R2DeezNuts/EggBot-Sumo-Battlebot-/README.md

# Proxecto Battlebot · Equipo Eggbots

Este repositorio reúne o deseño, o software e a documentación do noso BattleBot. A [web de Eggbots](https://battlebots.robotica.gal/Eggbots/) recolle a documentación completa do proxecto.

## Equipo
O equipo está formado por:
- **Enrique Comesaña Figueroa**: Coordinador e responsable do deseño de hardware e da construción.
- **Juan José Prado Neira**: Responsable do deseño e da implementación do software.
- **Marcos Fernández González**: Responsable da web e da documentación.
- **Javier Rego Bargos**: Responsable do deseño mecánico e electrónico.

## Estrutura do repositorio

O repositorio organízase en:
- ***README.md***: Este ficheiro.
- ***web***: Código fonte da web do proxecto.
- ***electronica***: Deseño dos circuítos de control e das placas.
- ***mecanica***: Deseño da estrutura do robot e planos de fabricación.
- ***software***: Software do robot.
- ***.gitlab-ci.yml***: Proceso de publicación da web.

## Compoñentes

Consulta a [lista de compoñentes](https://docs.google.com/spreadsheets/d/1ZMKZPNqryC1lRq46kaxvph4U0cHYfyVd0BvwiHCcG7o/edit?usp=sharing) para ver o material empregado.
