R2DeezNuts/EggBot-Sumo-Battlebot-/web/costes.md

---
layout: page
title: Costes a materiais
---

| Compoñente | Cantidade | Prezo aprox. (EUR) | Comentarios | Enlace de compra |
|---|---|---|---|---|
| **Motor Mabuchi RZ‑735VA‑9517 con cables cortos**| 2 | 17,395 |Motor, peso 290g | [Aliexprees](https://es.aliexpress.com/item/1005008892261311.html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) |
| **Sensor reflectancia QRE1113 sin cables** | 4 | 1,0225 | peso 0,5g | [Aliexprees](https://es.aliexpress.com/item/1005006863973407.html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) |
| **Sensor infrarrojo distancia con cables** | 1 | 5,34 | peso 17g | [Aliexprees](https://es.aliexpress.com/item/1005006989122809.html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) |
| **Sensores GP2Y0A21YK0F con cables** | 2 | 3,845 | Peso 12g | [Aliexpress](https://es.aliexpress.com/item/1005003745155535.html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) |
| **Tornillos varios ** | 1 | 1 | peso 40g |  |
| **Bateria 4s 850mAh 150C** | 1 | 0 | Peso 100g | |
| **Terminal** | 4 | 0,02 | peso 1 g | |
| **Chasis ABS completo** | 1 |0 | peso 350g | |
| **Cuña frontal 1 acero mm** | 1 | 0 | 35g | |
| **Eje 200x5 al 6061 hueco 5x3** | 3 | 0 | peso 3g,5g | |
| **Eje 72x5 al 6061 macizos** | 2 | 0 | peso 3g,9g | |
| **Llanta 35 mm × 22 mm ancho** | 2 | 0 | peso 16g | |
| **PCB** | 1 | 8,86 | peso 18g | |
| **220 uF 16v electrolitico** | 1 | 0,6 | peso 1g | |
| **0,1 uF ceramico** | 7 | 1,50 | peso 01g | |
| **1000uF 25v electrolitico** | 1 | 0,04 | Peso 3g  | |
| **Interruptor** | 1 | 0,2 | Peso 3g | |
| **Silicona ruedas** | 2 | 12,45 | Peso 23g | |
| **Placa módulo 12V–48V 100A sin cables** | 1 | 43,02 | Peso 90g | [Aliexprees](https://es.aliexpress.com/item/32728776675.html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) |
| **Convertidor DC‑DC 3A 5V BEC con cables** | 1 | 2,98 | Peso 6g |[Aliexprees](https://es.aliexpress.com/item/32905033708.html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) |
| **XT30 M-F + 14awg** | 3 | 0 | Peso 6g  | |

| **Fusible 80A**                            | 1        | 2,5              | Peso 8g  |                                                                                                                                 |

| **Cables varios**                            | 1        | 0              | Peso 6g  |                                                                                                                                 |

| **ESP32-WROOM-32U**                            | 1        | 0              | Peso 9g  |                                                                                                                                 |

**Total aproximado (sen incluír o custo da man de obra):** 151 EUR (depende de calidade e lugar de compra)

### Notas:
- Os prezos son estimativos, poden variar segundo país e fornecedor.
- O chasis impreso en 3D pode substituírse por acrílicom, madeira ou aluminio.
- Esta lista cobre **hardware**, o software é libre.
