R2DeezNuts/EggBot-Sumo-Battlebot-/software/README.md

# Deseño software do robot
Nesta carpeta incluense implementación do software e información de instalación no robot.

A carpeta ten a seguinte estructura:
- ...
- ...
