R2DeezNuts/EggBot-Sumo-Battlebot-/web/fotos.md

---
layout: page
title: Fotos e vídeos
---

<div class="gallery">
  <div class="photo">
    Foto 1
    <p>O logo do equipo, que na portada ás veces se fai de rogar.</p>
  </div>
  <div class="photo">
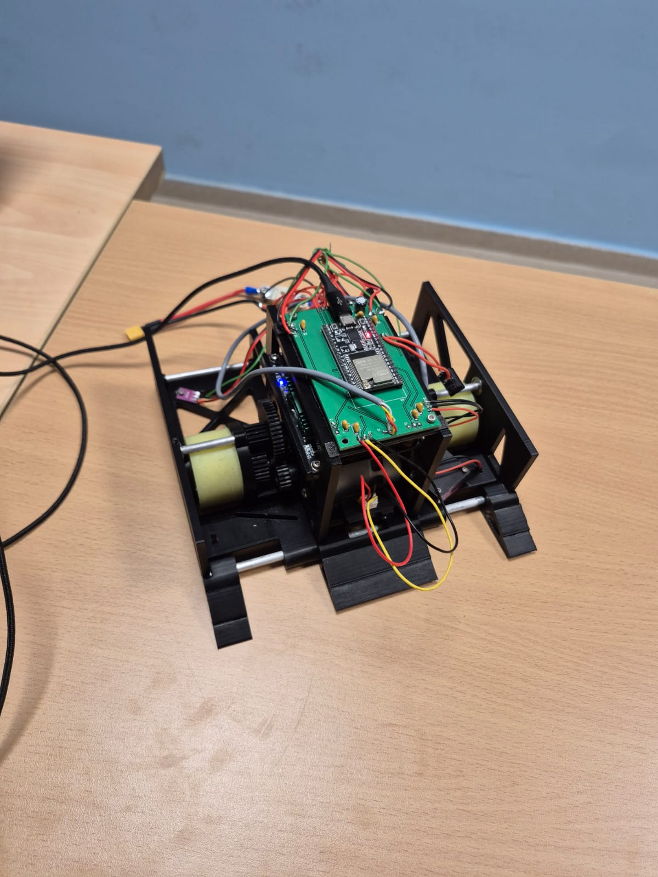
[picture p1: web/assets/fotos/battlebot.jpg]
Foto 2
    
    <p>Montaxe da placa controladora con ESP32.</p>
  </div>
  <div class="photo">
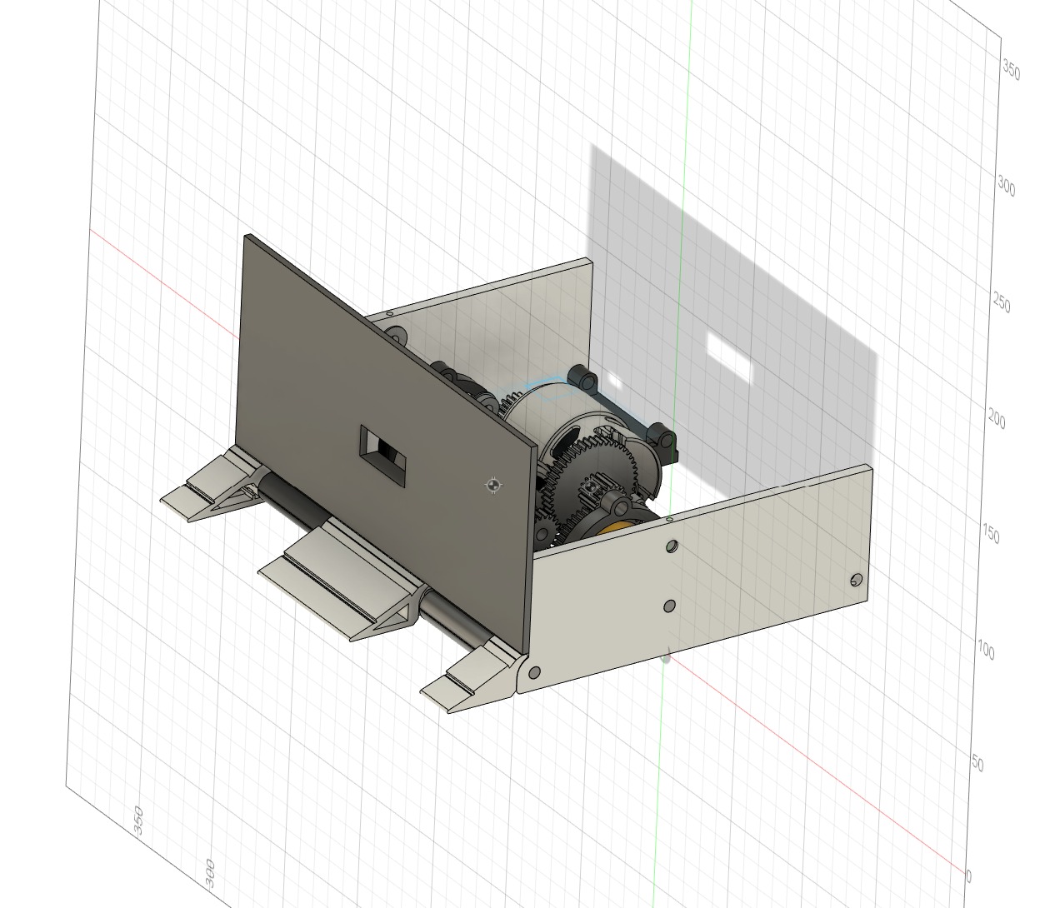
[picture p2: web/assets/fotos/battlebot_3D.jpg]
Foto 3
    
    <p>Un dos primeiros prototipos do chasis, impreso en 3D.</p>
  </div>
</div>

<style>
.gallery {
  display: flex;
  flex-wrap: wrap;
  gap: 20px;
  justify-content: center;
}
.photo {
  flex: 1 1 200px;
  text-align: center;
}
.photo img {
  max-width: 100%;
  border-radius: 8px;
  box-shadow: 0 2px 6px rgba(0,0,0,0.3);
}
.photo p {
  margin-top: 0.5em;
  font-size: 0.9em;
}
</style>
