R2DeezNuts/EggBot-Sumo-Battlebot-/web/index.md

---
layout: page
title: Inicio
---

# Benvido á web do equipo Eggbots

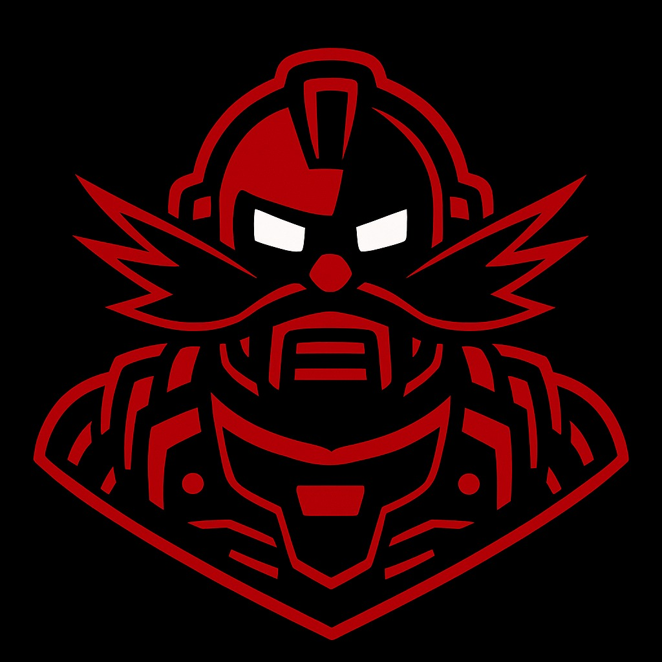
[picture p3: web/assets/img/Eggbots.png]
Logo Equipo Modelo


Somos estudantes do grao de Robótica da USC e estamos a construír un robot de combate pensado para moverse rápido e empuxar forte. O obxectivo é sinxelo: sacar o rival do cadrilátero antes de que nos saque a nós.

# O noso equipo

Aquí estamos as persoas que levamos o proxecto adiante:

<div class="team">
  <div class="member">
    <h2>Javier Rego Bargos</h2>
    <h3><strong>Rol: </strong>Programador</h3>
    <p>Encárgome do código que fai que o robot responda na area de combate. Moito dese código acaba sendo probar, medir e volver probar.</p>
  </div>

  <hr>

  <div class="member">
    <h2>Juan José Prado Neira</h2>
    <h3><strong>Rol: </strong>Líder do equipo, deseñador 3D e electrónico</h3>
    <p>Deseño o robot en 3D e a placa electrónica. Tamén coordino o equipo para que as pezas, o software e as probas vaian na mesma dirección.</p>
  </div>

  <hr>

  <div class="member">
    <h2>David Díaz González</h2>
    <h3><strong>Rol: </strong>Web e deseño mecánico</h3>
    <p>Actualizo a web e poño nela as especificacións do proxecto. No deseño mecánico, encárgome de que o robot cumpra as condicións da USC e aguante cando chega o momento de competir.</p>
  </div>
</div>

<style>
.logo_equipo {
    max-height: 300px;
}
.team {
  justify-content: space-around;
  gap: 20px;
  margin-top: 2rem;
}
</style>
