R2DeezNuts/EggBot-Sumo-Battlebot-/mecanica/Fusion/20251214_204636.jpg

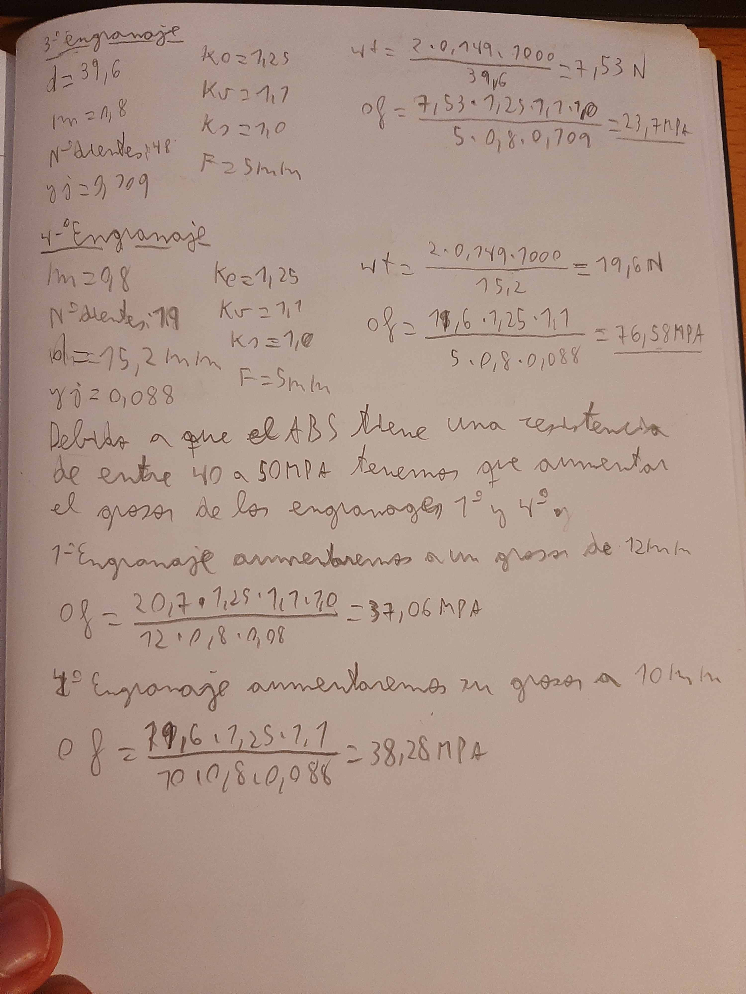
mecanica/Fusion/20251214_204636.jpg
