R2DeezNuts/EggBot-Sumo-Battlebot-/web/assets/fotos/63kehim7mik71.webp

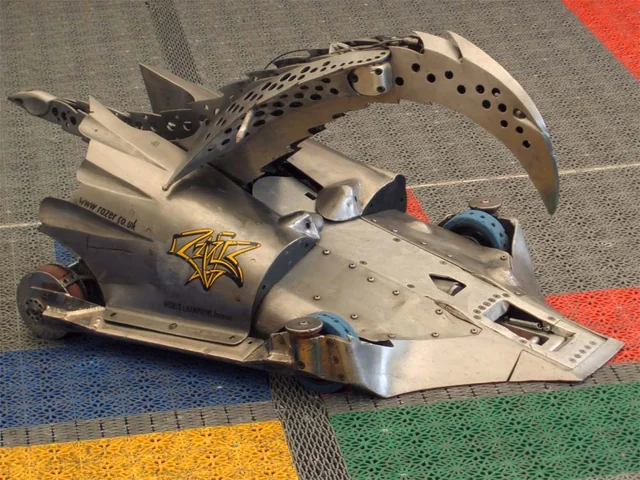
web/assets/fotos/63kehim7mik71.webp
