R2DeezNuts/EggBot-Sumo-Battlebot-/web/assets/fotos/FTAFVW1HI3TXU4G.jpg

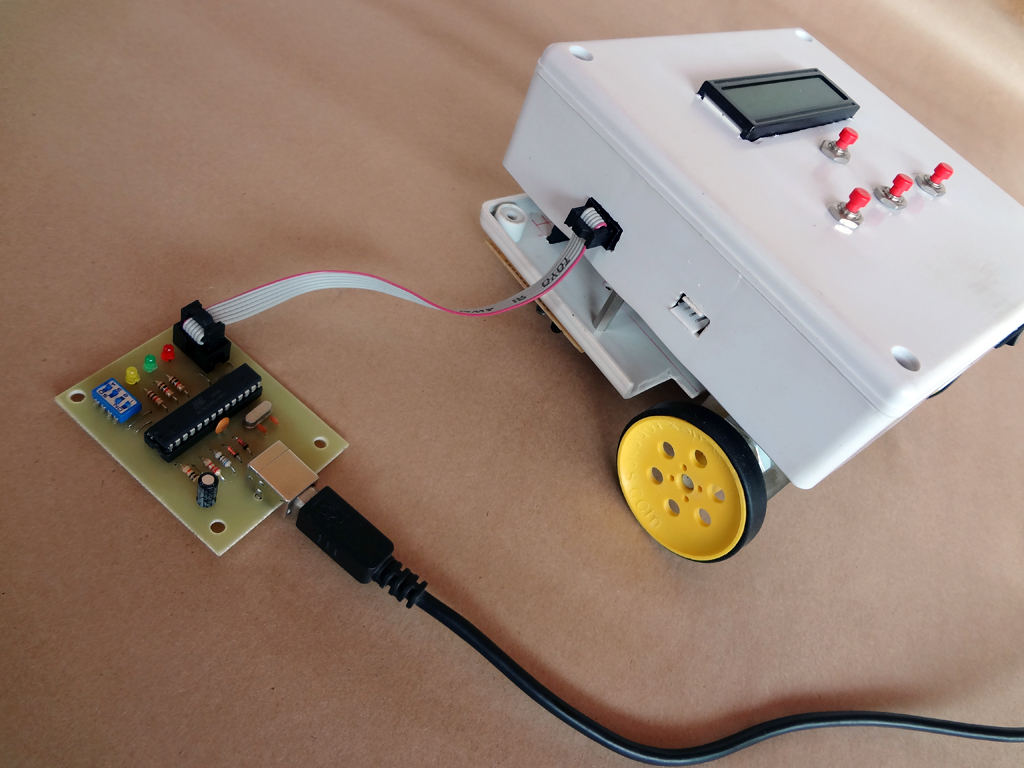
web/assets/fotos/FTAFVW1HI3TXU4G.jpg
