R2DeezNuts/EggBot-Sumo-Battlebot-/web/assets/img/foto_daniel.jpeg

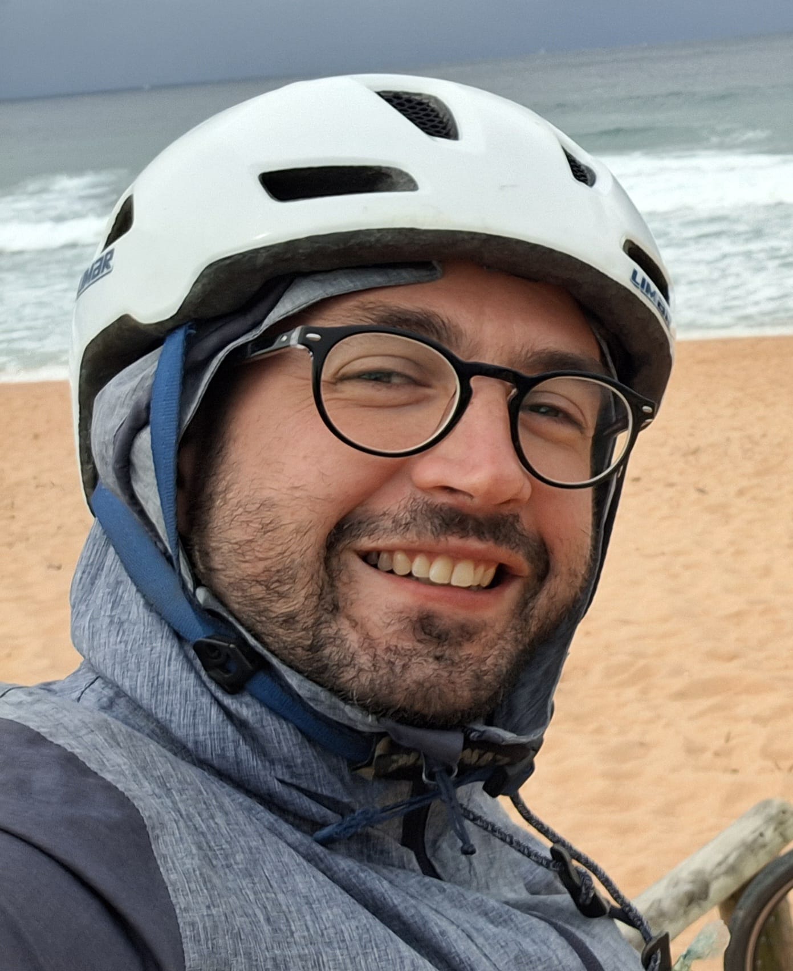
web/assets/img/foto_daniel.jpeg
