R2DeezNuts/EggBot-Sumo-Battlebot-/web/assets/img/foto_enrique.jpeg

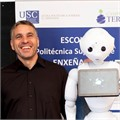
web/assets/img/foto_enrique.jpeg
