R2DeezNuts/EggBot-Sumo-Battlebot-/web/assets/img/foto_marcos.jpeg

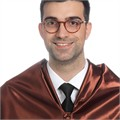
web/assets/img/foto_marcos.jpeg
