R2DeezNuts/EggBot-Sumo-Battlebot-/WhatsApp Image 2026-09-12 at 15.47.21.jpeg

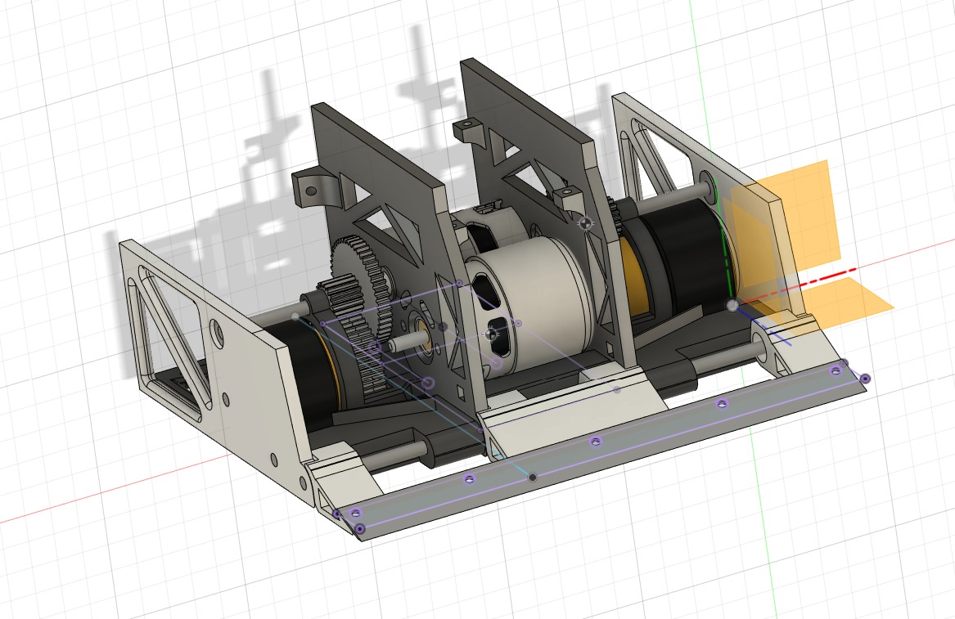
WhatsApp Image 2026-09-12 at 15.47.21.jpeg
