R2DeezNuts/EggBot-Sumo-Battlebot-/(list of files, cad)

Other CAD files:
mecanica/Fusion/battlebot_V2.f3d
