R2DeezNuts/EggBot-Sumo-Battlebot-/electronica/eggbot/eggbot.kicad_pcb

## KiCad design electronica/eggbot/eggbot.kicad_pcb (2026-09-12)

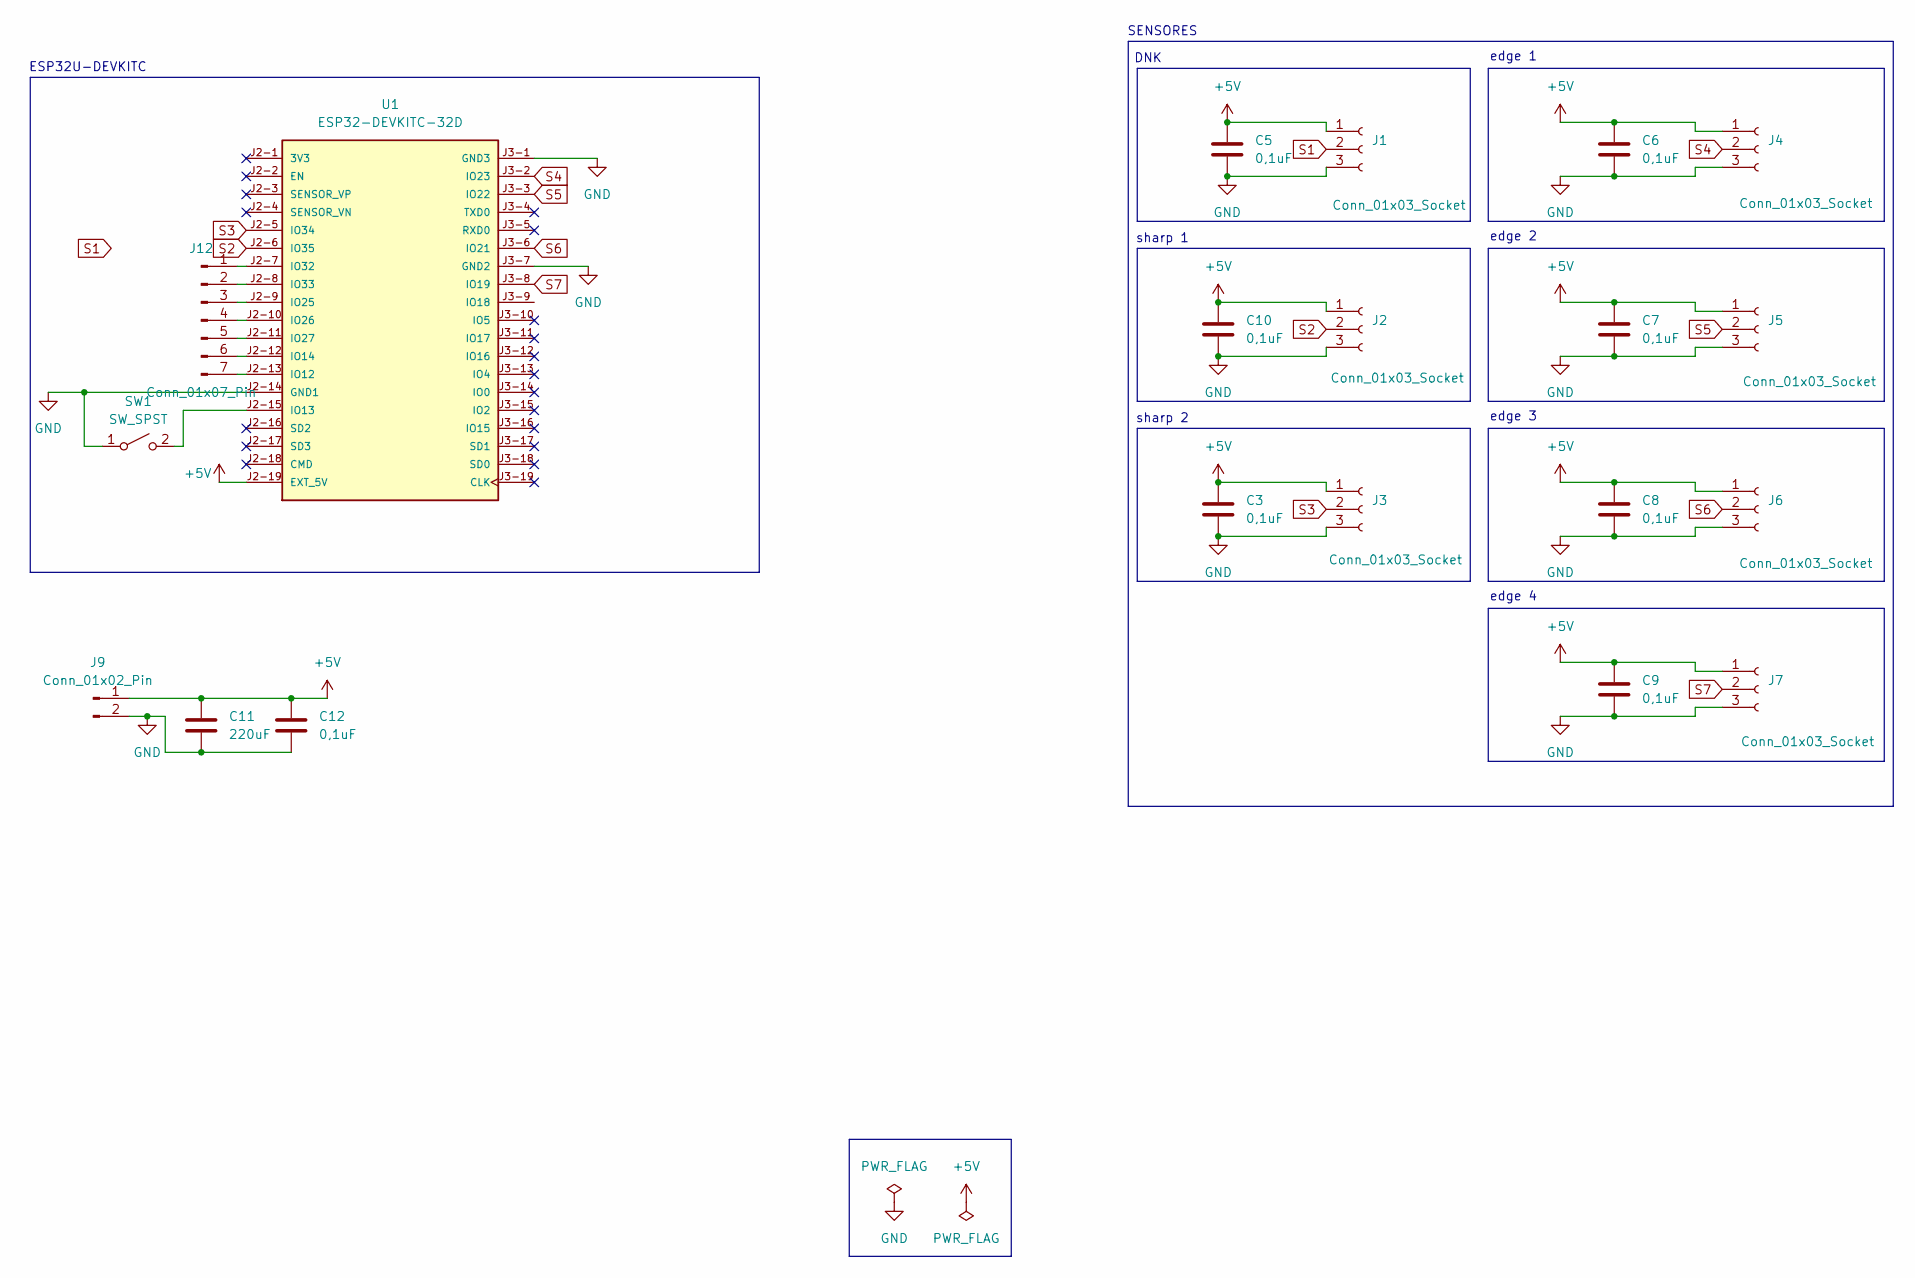
[picture p12: schematic eggbot.kicad_sch, battle_eggbot]

Parts:
C3, C5, C6, C7, C8, C9, C10, C12: 0,1uF; C_Disc_D4.3mm_W1.9mm_P5.00mm
C11: 220uF; CP_Radial_D4.0mm_P2.00mm
J1, J2, J3, J4, J5, J6, J7: Conn_01x03_Socket; pad_sensores_v2
J9: Conn_01x02_Pin; pad_salida_UBEC
J12: Conn_01x07_Pin; pad_7
SW1: SW_SPST; pad_2_èq
U1: ESP32-DEVKITC-32D; MODULE_ESP32-DEVKITC-32D; PARTREV V4

Connections:
+5V: C3.2, C5.2, C6.2, C7.2, C8.2, C9.2, C10.2, C11.2, C12.2, J1.1, J2.1, J3.1, J4.1, J5.1, J6.1, J7.1, J9.1, U1.J2-19 (EXT_5V)
GND: C3.1, C5.1, C6.1, C7.1, C8.1, C9.1, C10.1, C11.1, C12.1, J1.3, J2.3, J3.3, J4.3, J5.3, J6.3, J7.3, J9.2, SW1.1 (A), U1.J2-14 (GND1), U1.J3-1 (GND3), U1.J3-7 (GND2)
unnamed: J12.1, U1.J2-7 (IO32)
unnamed: J12.2, U1.J2-8 (IO33)
unnamed: J12.3, U1.J2-9 (IO25)
unnamed: J12.4, U1.J2-10 (IO26)
unnamed: J12.5, U1.J2-11 (IO27)
unnamed: J12.6, U1.J2-12 (IO14)
unnamed: J12.7, U1.J2-13 (IO12)
unnamed: SW1.2 (B), U1.J2-15 (IO13)
S1: J1.2, U1.J3-9 (IO18)
S2: J2.2, U1.J2-6 (IO35)
S3: J3.2, U1.J2-5 (IO34)
S4: J4.2, U1.J3-2 (IO23)
S5: J5.2, U1.J3-3 (IO22)
S6: J6.2, U1.J3-6 (IO21)
S7: J7.2, U1.J3-8 (IO19)

Notes on the sheet:
sharp 1
edge 3
DNK
ESP32U-DEVKITC
SENSORES
edge 4
edge 1
sharp 2
edge 2

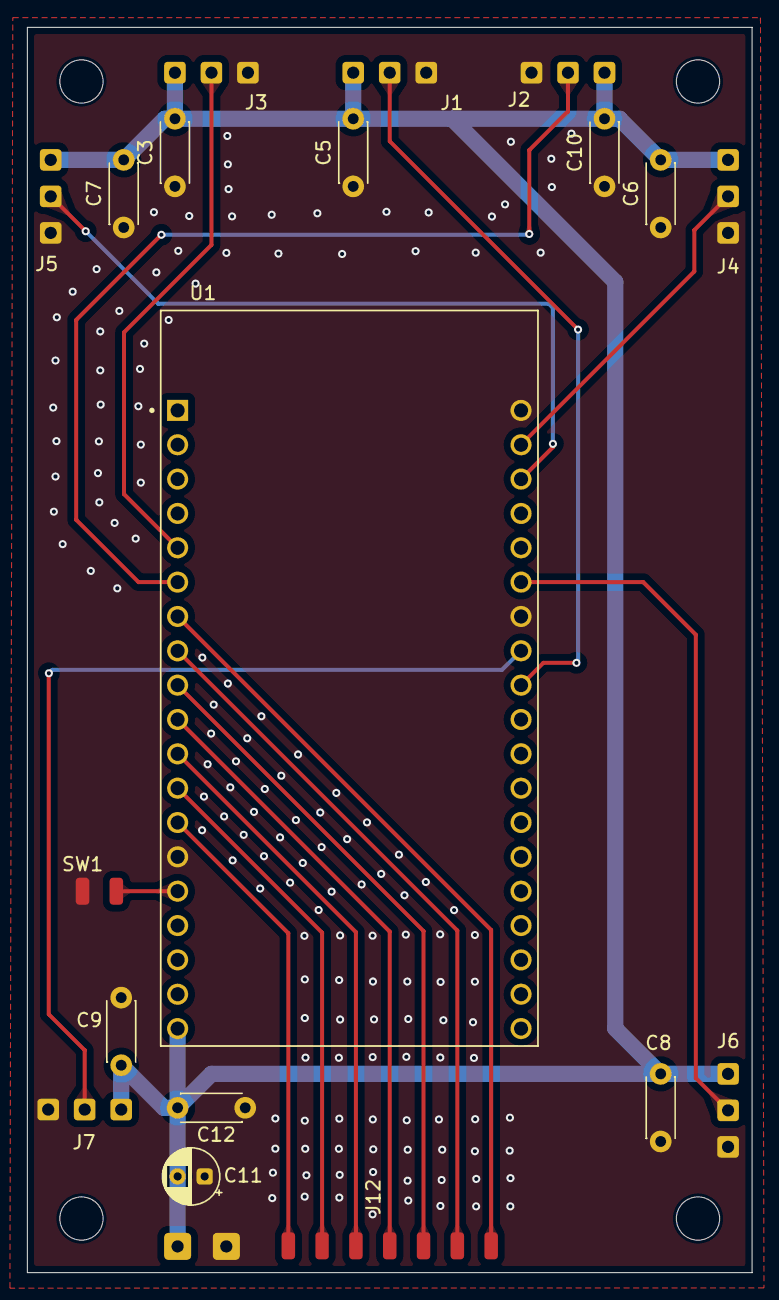
[picture p13: board eggbot.kicad_pcb from above]

Board: 2 copper layers, 53.6 x 92.1 mm, 24 parts (0 on the bottom side), 17 nets.

Other parts of the board:
H0, H1, H3, H4: MountingHole_3.2mm_M3
